iOtoniel/esp32-minigame-ultrassom/data/campo.png

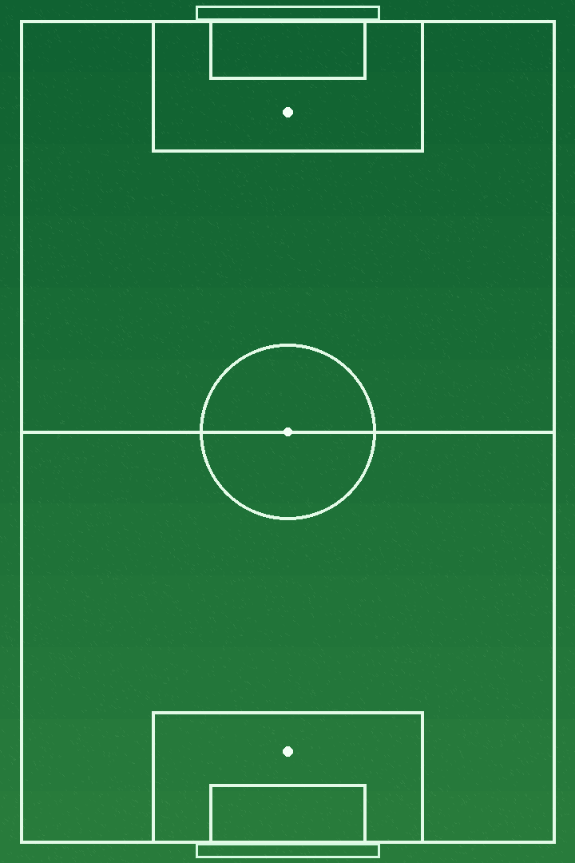
data/campo.png
